HotScotch4321/2200/PCB_Projects/SensorBoard/EGB220_Ordering_MaximusVu.xlsx

TS EE&I Order Template v3
Name | Maximus Vu |  | Unit | EGB220 |  |  | Do not leave empty cells in the descriptions.
Email | n11494581@qut.edu.au |  | Group | B6 |  |  | Do not change formatting or file type.
Account | 323500-0161-01 ( EER UG Students ) |  |  |  |  |  | Complete this form and email to foe.eei@qut.edu.au
Supervisor | Matthew Dunbabin |  | Multiplier | 1 |  |  | Also cc your supervisor who will authorise the order
Item | Description | Quantity | Cost Each | Currency | Supplier | Order Code | Web Link
1 | CAP CER 0.1UF 100V X7R 1206 | 1 | $0.32 | AUD | digikey | 478-KGM31DR72A104KUCT-ND | https://www.digikey.com.au/en/products/detail/kyocera-avx/KGM31DR72A104KU/563639
2 | LED RED CLEAR 0603 SMD | 1 | $0.22 | AUD | digikey | 732-4978-1-ND | https://www.digikey.com.au/en/products/detail/w%C3%BCrth-elektronik/150060RS75000/4489901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
3 | RES 200 OHM 1% 1/2W 1206 | 14 | $0.03 | AUD | digikey | RNCP1206FTD200RCT-ND | https://www.digikey.com.au/en/products/detail/stackpole-electronics-inc/RNCP1206FTD200R/2240320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
4 | RES 10K OHM 5% 1/4W 1206 | 14 | $0.06 | AUD | digikey | A130183CT-ND | https://www.digikey.com.au/en/products/detail/te-connectivity-passive-product/CRGCQ1206J10K/8576785
5 | RES SMD 150 OHM 5% 1/10W 0603 | 1 | $0.15 | AUD | digikey | CR0603-JW-151ELFCT-ND | https://www.digikey.com.au/en/products/detail/bourns-inc/CR0603-JW-151ELF/3784293
6 | SENSOR OPTO TRANS REFL SMD PHOTO | 14 | $1.13 | AUD | digikey | QRE1113GRCT-ND | https://www.digikey.com.au/en/products/detail/onsemi/QRE1113GR/965451
7 | IC MUX 16:1 160OHM 24SOIC | 1 | $1.15 | AUD | digikey | 296-29408-1-ND | https://www.digikey.com.au/en/products/detail/texas-instruments/CD74HC4067M96/1507236
8
9
10
11
12
13
14
15
16
17
18
19
20
21
22
23
24
25
26
27
28
29
30
31
32
33
34
35
36
37
38
39
40
41
42
43
44
45
46
47
48
49
50
