HotScotch4321/2200/PCB_Projects/breakoutB/STEP_file/.step

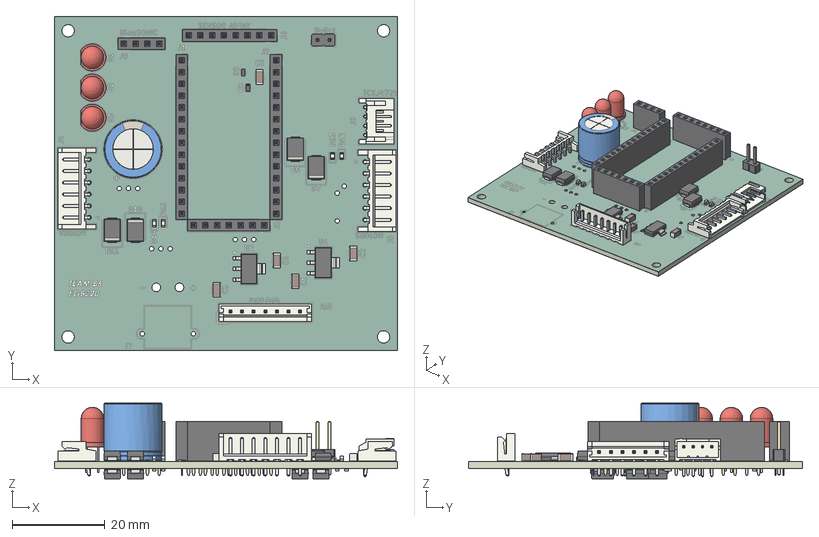
[picture p1: CAD file, 2026-05-04]
PCB_Projects/breakoutB/STEP_file/.step
74.0 x 72.0 x 16.3 mm
C_1206_3216Metric x 5
PinSocket_1x08_P2.54mm_Vertical
PinSocket_1x07_P2.54mm_Vertical
LED_0603_1608Metric x 4
CP_Radial_D12.5mm_P5.00mm
SOT-223 x 2
PinSocket_1x14_P2.54mm_Vertical x 2
R_0603_1608Metric x 9
JST_EH_S6B-EH_1x06_P2.50mm_Horizontal x 2
D_SMB x 8
LED_D5.0mm x 3
JST_PH_S4B-PH-K_1x04_P2.00mm_Horizontal
PinSocket_1x04_P2.54mm_Vertical
PinHeader_1x02_P2.54mm_Vertical
JST_EH_B7B-EH-A_1x07_P2.50mm_Vertical
breakoutB_silkscreen x 2
breakoutB_soldermask x 2
breakoutB_PCB
