HotScotch4321/2200/PCB_Projects/LDL1117S50R_/LDL1117S50R_.step

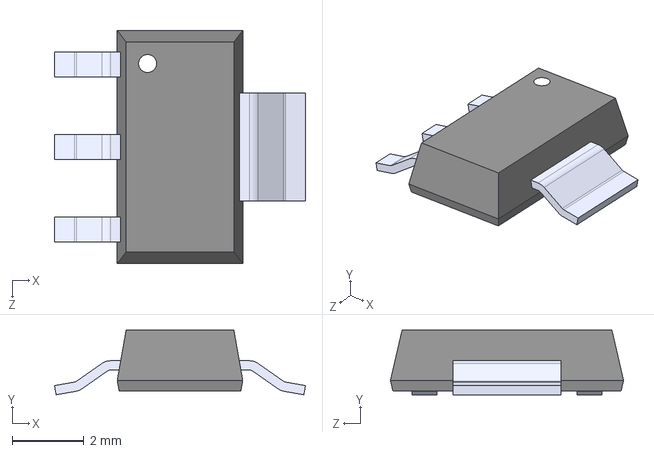
[picture p2: CAD file, 2026-05-04]
PCB_Projects/LDL1117S50R_/LDL1117S50R_.step
7.00 x 1.80 x 6.50 mm
