HotScotch4321/2200/PCB_Projects/SensorBoard/Fusion/Sensor_board.step

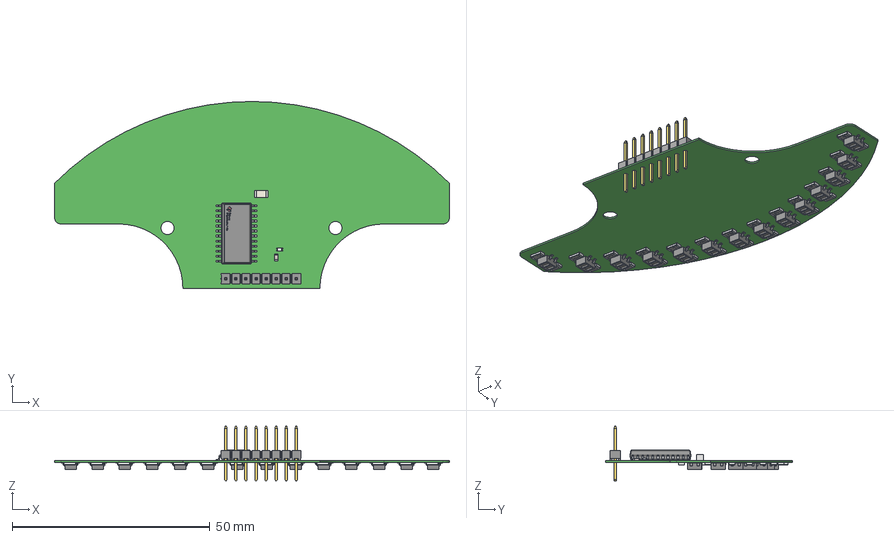
[picture p3: CAD file, 2026-03-11]
PCB_Projects/SensorBoard/Fusion/Sensor_board.step
99.8 x 47.3 x 13.8 mm
Extruded x 6
IC_ON_Semi_QRE1113GR_eec x 70
pins x 14
top x 14
part number x 14
Res_Stackpole_Electronics_RNCP1206FTD1K00_eec x 98
BODY-SO
LEAD-SO x 24
Texas Logo Yury
Texas Logo Yury - Copy
housing
cover
base x 2
Polarity Mark
TSW-108-08-G-S_body
T-1S6-08-TSW-1-08-8-S
