HotScotch4321/2200/(list of files, cad)

Other CAD files:
PCB_Projects/breakoutB/STEP_file/BreakoutBoard.step
