HotScotch4321/2200/firmware/SparkMOB/test/data_fig1_sensor.csv

line_offset_mm | computed_position_units_clean | computed_position_units_noisy
-45.00 | -272.23 | -311.56
-44.80 | -281.48 | -313.85
-44.60 | -290.65 | -264.17
-44.40 | -299.71 | -292.25
-44.20 | -308.65 | -281.66
-44.00 | -317.44 | -312.92
-43.80 | -326.09 | -327.80
-43.60 | -334.57 | -321.21
-43.40 | -342.88 | -342.26
-43.20 | -350.99 | -370.73
-43.00 | -358.91 | -358.05
-42.80 | -366.62 | -379.01
-42.60 | -374.12 | -401.15
-42.40 | -381.41 | -374.22
-42.20 | -388.47 | -382.03
-42.00 | -395.30 | -377.82
-41.80 | -401.90 | -440.82
-41.60 | -408.28 | -426.97
-41.40 | -414.42 | -447.84
-41.20 | -420.32 | -395.73
-41.00 | -426.00 | -416.15
-40.80 | -431.44 | -432.16
-40.60 | -436.65 | -423.63
-40.40 | -441.63 | -439.44
-40.20 | -446.39 | -440.49
-40.00 | -450.92 | -439.60
-39.80 | -455.23 | -457.62
-39.60 | -459.32 | -448.92
-39.40 | -463.20 | -464.16
-39.20 | -466.87 | -463.19
-39.00 | -470.32 | -467.26
-38.80 | -473.57 | -462.89
-38.60 | -476.62 | -473.37
-38.40 | -479.47 | -468.28
-38.20 | -482.13 | -493.09
-38.00 | -484.60 | -489.94
-37.80 | -486.88 | -478.71
-37.60 | -488.97 | -499.39
-37.40 | -490.89 | -516.47
-37.20 | -492.63 | -491.76
-37.00 | -494.19 | -498.83
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
