HotScotch4321/2200/firmware/SparkMOB/test/data_fig2_line_pd.csv

time_s | pos_Kp1.0_Kd0.0 | pos_Kp1.0_Kd0.1 | pos_Kp1.0_Kd0.5
0.000 | 63.72 | 63.72 | 63.72
0.010 | 62.55 | 62.05 | 62.05
0.020 | 60.21 | 58.86 | 60.09
0.030 | 56.77 | 55.16 | 58.83
0.040 | 52.26 | 51.12 | 57.65
0.050 | 46.76 | 46.86 | 56.49
0.060 | 40.36 | 42.51 | 55.36
0.070 | 33.17 | 38.15 | 54.25
0.080 | 25.31 | 33.89 | 53.16
0.090 | 16.92 | 29.77 | 52.09
0.100 | 8.17 | 25.85 | 51.05
0.110 | -0.75 | 22.18 | 50.03
0.120 | -9.65 | 18.78 | 49.02
0.130 | -18.35 | 15.66 | 48.04
0.140 | -26.66 | 12.83 | 47.08
0.150 | -34.42 | 10.30 | 46.13
0.160 | -41.49 | 8.05 | 45.21
0.170 | -47.75 | 6.08 | 44.30
0.180 | -53.08 | 4.37 | 43.41
0.190 | -57.42 | 2.90 | 42.54
0.200 | -60.68 | 1.66 | 41.69
0.210 | -62.82 | 0.62 | 40.86
0.220 | -63.80 | -0.23 | 40.04
0.230 | -63.60 | -0.91 | 39.23
0.240 | -62.24 | -1.44 | 38.45
0.250 | -59.71 | -1.84 | 37.68
0.260 | -56.09 | -2.13 | 36.92
0.270 | -51.41 | -2.33 | 36.18
0.280 | -45.75 | -2.44 | 35.46
0.290 | -39.21 | -2.48 | 34.75
0.300 | -31.90 | -2.47 | 34.05
0.310 | -23.94 | -2.41 | 33.37
0.320 | -15.48 | -2.32 | 32.70
0.330 | -6.69 | -2.20 | 32.04
0.340 | 2.24 | -2.06 | 31.40
0.350 | 11.13 | -1.91 | 30.77
0.360 | 19.77 | -1.75 | 30.16
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
