HotScotch4321/2200/firmware/SparkMOB/test/data_fig4_timeline.csv

time_s | left_wheel_ms | right_wheel_ms | state
0.000 | 0.0944 | 0.0944 | FOLLOW (straight)
0.010 | 0.1731 | 0.1731 | FOLLOW (straight)
0.020 | 0.2387 | 0.2387 | FOLLOW (straight)
0.030 | 0.2934 | 0.2934 | FOLLOW (straight)
0.040 | 0.3389 | 0.3389 | FOLLOW (straight)
0.050 | 0.3769 | 0.3769 | FOLLOW (straight)
0.060 | 0.4085 | 0.4085 | FOLLOW (straight)
0.070 | 0.4281 | 0.4309 | FOLLOW (straight)
0.080 | 0.4350 | 0.4400 | FOLLOW (straight)
0.090 | 0.4351 | 0.4417 | FOLLOW (straight)
0.100 | 0.4316 | 0.4396 | FOLLOW (straight)
0.110 | 0.4267 | 0.4358 | FOLLOW (straight)
0.120 | 0.4214 | 0.4316 | FOLLOW (straight)
0.130 | 0.4163 | 0.4275 | FOLLOW (straight)
0.140 | 0.4118 | 0.4238 | FOLLOW (straight)
0.150 | 0.4078 | 0.4207 | FOLLOW (straight)
0.160 | 0.4044 | 0.4181 | FOLLOW (straight)
0.170 | 0.4016 | 0.4161 | FOLLOW (straight)
0.180 | 0.3993 | 0.4145 | FOLLOW (straight)
0.190 | 0.3974 | 0.4133 | FOLLOW (straight)
0.200 | 0.3959 | 0.4124 | FOLLOW (straight)
0.210 | 0.3946 | 0.4118 | FOLLOW (straight)
0.220 | 0.3936 | 0.4113 | FOLLOW (straight)
0.230 | 0.3927 | 0.4110 | FOLLOW (straight)
0.240 | 0.3920 | 0.4109 | FOLLOW (straight)
0.250 | 0.3914 | 0.4108 | FOLLOW (straight)
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
