HotScotch4321/2200/firmware/SparkMOB/test/line_Kp0p3.csv

t_ms | position | error | pid_out
0 | 66 | -66 | 0
10 | 39 | -39 | 0
20 | 43 | -43 | 0
30 | 35 | -35 | 0
40 | 31 | -31 | 0
50 | 27 | -27 | 0
60 | 21 | -21 | 0
70 | 20 | -20 | 0
80 | 16 | -16 | 0
90 | 18 | -18 | 0
100 | 10 | -10 | 0
110 | 8 | -8 | 0
120 | 5 | -5 | 0
130 | 3 | -3 | 0
140 | 1 | -1 | 0
150 | 0 | 0 | 0
160 | -1 | 1 | 0
170 | -3 | 3 | 0
180 | -3 | 3 | 0
190 | -6 | 6 | 0
200 | -6 | 6 | 0
210 | -5 | 5 | 0
220 | -8 | 8 | 0
230 | -9 | 9 | 0
240 | -9 | 9 | 0
250 | -9 | 9 | 0
260 | -8 | 8 | 0
270 | -11 | 11 | 0
280 | -11 | 11 | 0
290 | -9 | 9 | 0
300 | -12 | 12 | 0
310 | -11 | 11 | 0
320 | -10 | 10 | 0
330 | -10 | 10 | 0
340 | -10 | 10 | 0
350 | -9 | 9 | 0
360 | -14 | 14 | 0
370 | -8 | 8 | 0
380 | -11 | 11 | 0
390 | -11 | 11 | 0
400 | -8 | 8 | 0
410 | -8 | 8 | 0
420 | -9 | 9 | 0
430 | -9 | 9 | 0
440 | -7 | 7 | 0
450 | -7 | 7 | 0
460 | -5 | 5 | 0
470 | -6 | 6 | 0
480 | -6 | 6 | 0
490 | -5 | 5 | 0
500 | -6 | 6 | 0
510 | -7 | 7 | 0
520 | -4 | 4 | 0
530 | -4 | 4 | 0
540 | -5 | 5 | 0
550 | -5 | 5 | 0
560 | -4 | 4 | 0
570 | -7 | 7 | 0
580 | -2 | 2 | 0
590 | -3 | 3 | 0
600 | -5 | 5 | 0
610 | -2 | 2 | 0
620 | -4 | 4 | 0
630 | -1 | 1 | 0
640 | -5 | 5 | 0
650 | -2 | 2 | 0
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
