HotScotch4321/2200/firmware/SparkMOB/test/line_Kp1p0.csv

t_ms | position | error | pid_out
0 | 62 | -62 | 0
10 | 30 | -30 | 0
20 | 25 | -25 | 0
30 | 13 | -13 | 0
40 | 5 | -5 | 0
50 | 4 | -4 | 0
60 | 0 | 0 | 0
70 | -1 | 1 | 0
80 | -5 | 5 | 0
90 | -2 | 2 | 0
100 | -4 | 4 | 0
110 | -3 | 3 | 0
120 | -6 | 6 | 0
130 | -5 | 5 | 0
140 | -7 | 7 | 0
150 | -1 | 1 | 0
160 | -9 | 9 | 0
170 | -2 | 2 | 0
180 | -6 | 6 | 0
190 | -5 | 5 | 0
200 | -4 | 4 | 0
210 | -4 | 4 | 0
220 | -3 | 3 | 0
230 | -4 | 4 | 0
240 | -1 | 1 | 0
250 | -6 | 6 | 0
260 | -2 | 2 | 0
270 | -4 | 4 | 0
280 | -1 | 1 | 0
290 | -5 | 5 | 0
300 | -1 | 1 | 0
310 | -2 | 2 | 0
320 | -4 | 4 | 0
330 | 0 | 0 | 0
340 | -2 | 2 | 0
350 | 0 | 0 | 0
360 | -1 | 1 | 0
370 | -3 | 3 | 0
380 | -2 | 2 | 0
390 | -1 | 1 | 0
400 | 0 | 0 | 0
410 | -1 | 1 | 0
420 | -3 | 3 | 0
430 | -2 | 2 | 0
440 | -2 | 2 | 0
450 | -1 | 1 | 0
460 | -1 | 1 | 0
470 | -1 | 1 | 0
480 | 2 | -2 | 0
490 | -3 | 3 | 0
500 | -1 | 1 | 0
510 | 0 | 0 | 0
520 | -2 | 2 | 0
530 | 0 | 0 | 0
540 | 0 | 0 | 0
550 | 0 | 0 | 0
560 | -3 | 3 | 0
570 | 2 | -2 | 0
580 | -2 | 2 | 0
590 | 0 | 0 | 0
600 | 0 | 0 | 0
610 | 0 | 0 | 0
620 | 0 | 0 | 0
630 | -1 | 1 | 0
640 | -1 | 1 | 0
650 | 0 | 0 | 0
660 | -2 | 2 | 0
670 | 2 | -2 | 0
680 | -2 | 2 | 0
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
