HotScotch4321/2200/firmware/SparkMOB/test/fig_test_slowzone.png

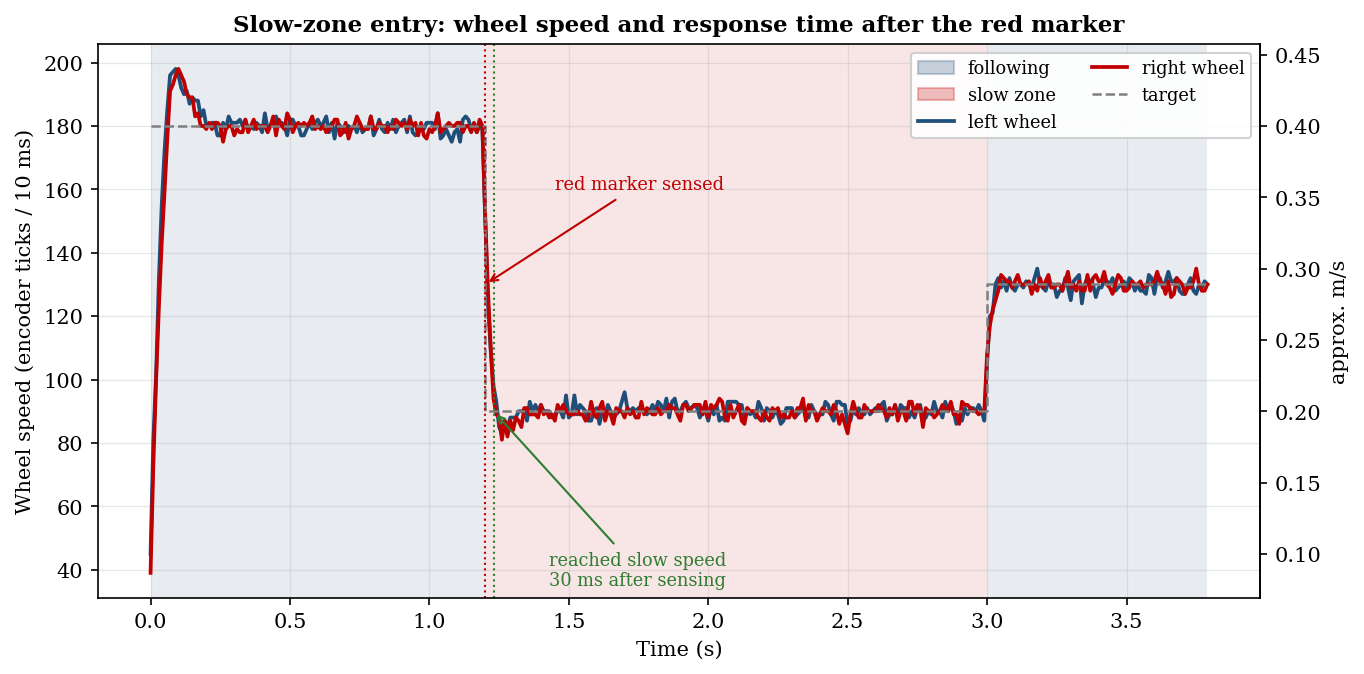
firmware/SparkMOB/test/fig_test_slowzone.png
