HotScotch4321/2200/firmware/SparkMOB/test/fig_test_speed.png

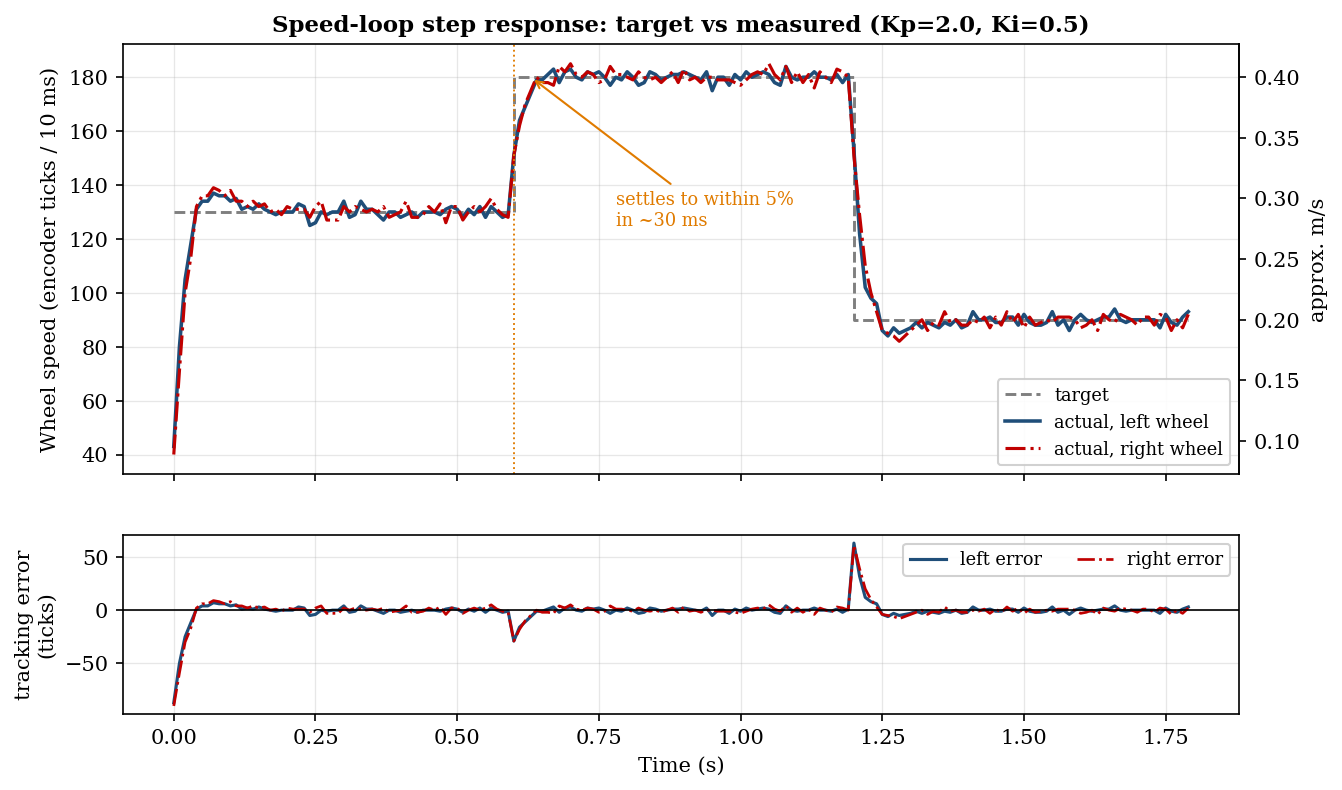
firmware/SparkMOB/test/fig_test_speed.png
