HotScotch4321/2200/(list of files, drawings)

Other design files:
PCB_Projects/breakoutSch/Breakout.SchDoc
PCB_Projects/MainBreakout.PrjPcb
PCB_Projects/Sensor_array.SchDoc
PCB_Projects/SensorBoard/board.SchDoc
PCB_Projects/SensorBoard/Copy of Sensor_board.PcbDoc
PCB_Projects/SensorBoard/sensor.SchDoc
PCB_Projects/SensorBoard/Sensor_board.PcbDoc
PCB_Projects/SensorBoard/SensorBoard.PrjPcb
