HotScotch4321/2200/PCB_Projects/breakoutB/breakoutB.kicad_pcb

## KiCad design PCB_Projects/breakoutB/breakoutB.kicad_pcb (2026-05-04)

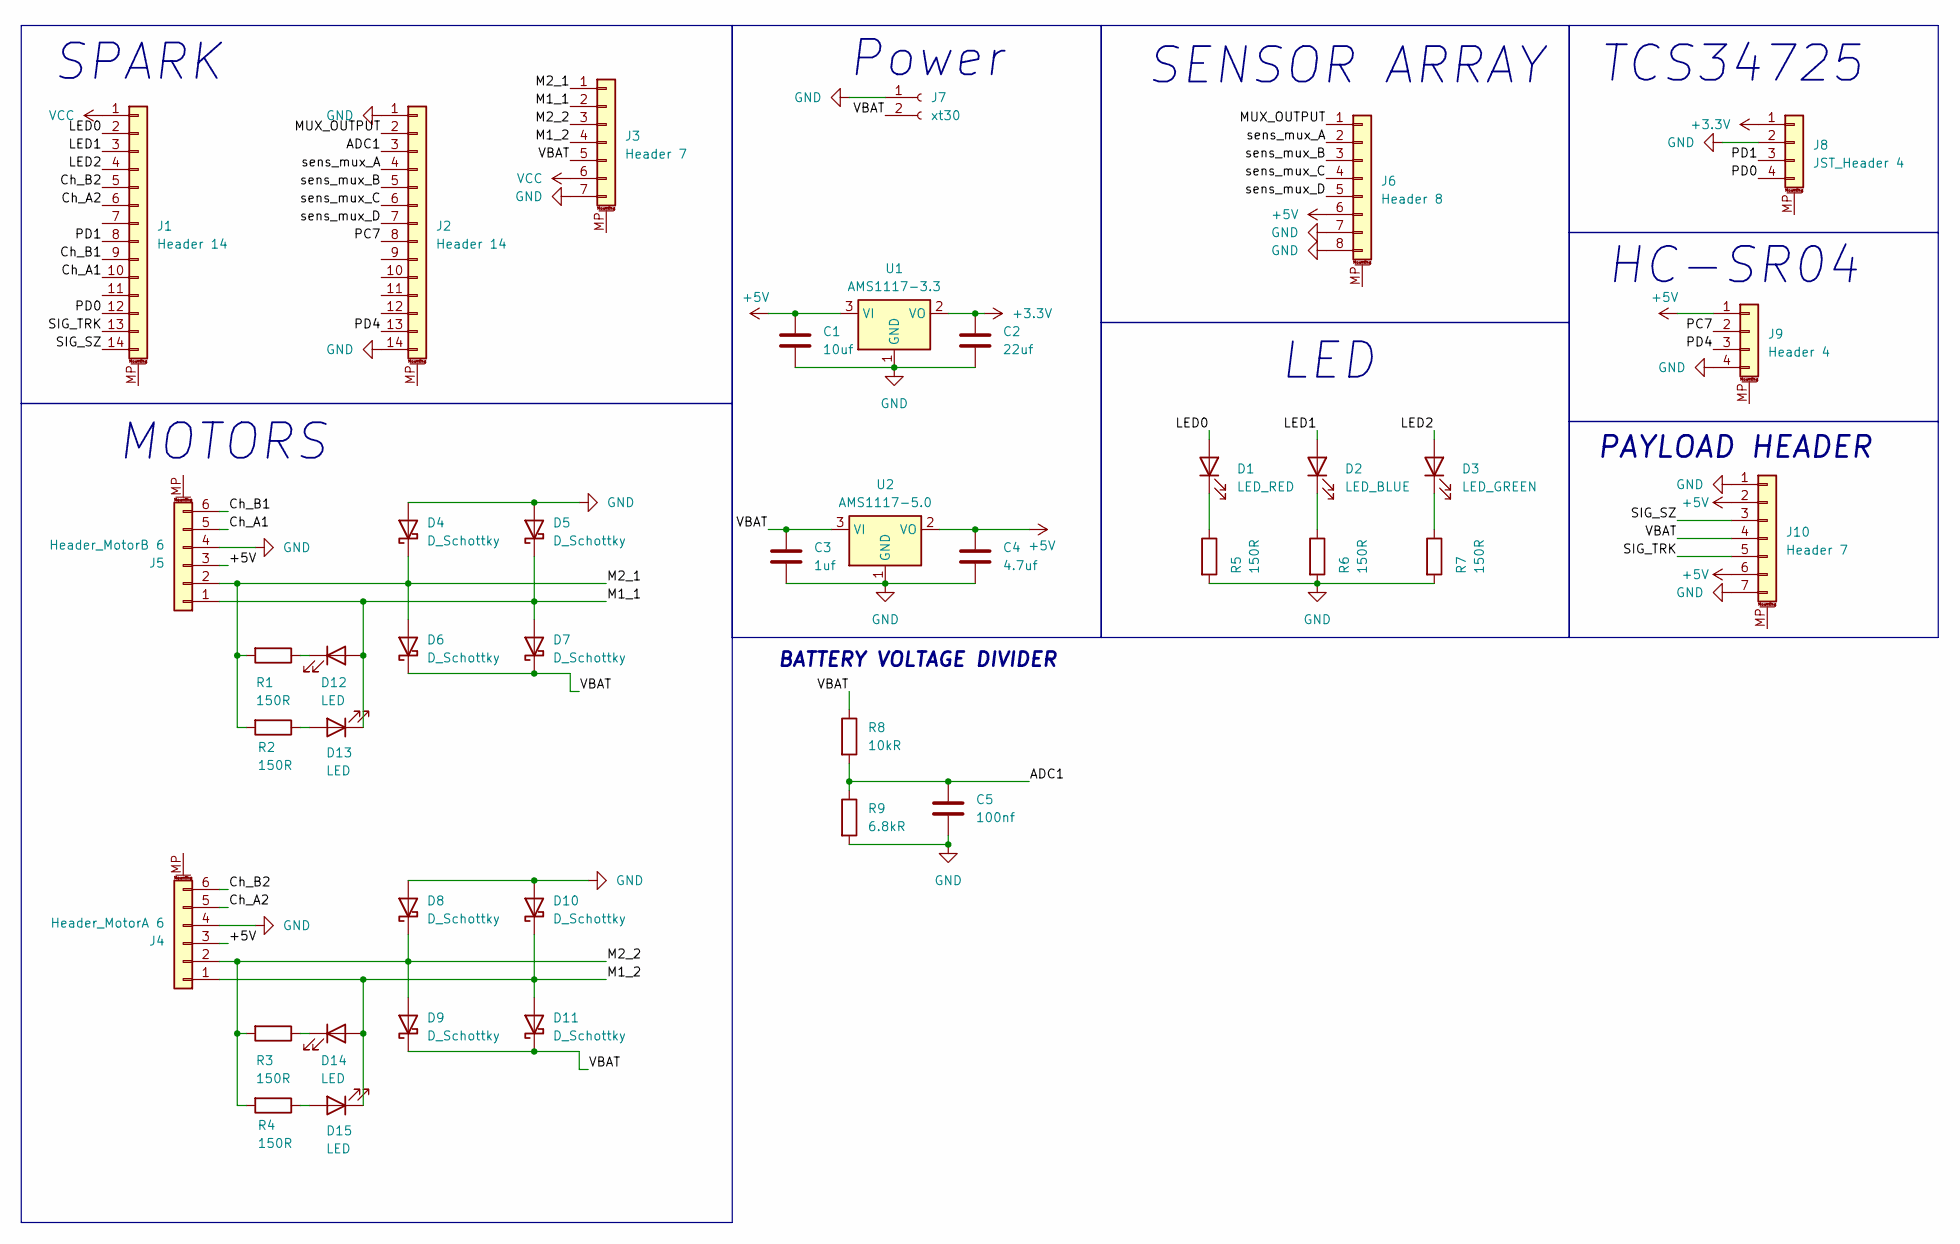
[picture p7: schematic breakoutB.kicad_sch]

Parts:
C1: 10uf; C_1206_3216Metric
C2: 22uf; C_1206_3216Metric
C3: 1uf; C_1206_3216Metric
C4: 4.7uf; C_1206_3216Metric
C5: 100nf; C_1206_3216Metric
D1: LED_RED; LED_D5.0mm
D2: LED_BLUE; LED_D5.0mm
D3: LED_GREEN; LED_D5.0mm
D4, D5, D6, D7, D8, D9, D10, D11: D_Schottky; D_SMB
D12, D13, D14, D15: LED; LED_0603_1608Metric
J1, J2: Header 14; PinSocket_1x14_P2.54mm_Vertical
J3: Header 7; PinSocket_1x07_P2.54mm_Vertical
J4: Header_MotorA 6; JST_EH_S6B-EH_1x06_P2.50mm_Horizontal
J5: Header_MotorB 6; JST_EH_S6B-EH_1x06_P2.50mm_Horizontal
J6: Header 8; PinSocket_1x08_P2.54mm_Vertical
J7: xt30; AMASS_XT30PW-M_1x02_P2.50mm_Horizontal
J8: JST_Header 4; JST_PH_S4B-PH-K_1x04_P2.00mm_Horizontal
J9: Header 4; PinSocket_1x04_P2.54mm_Vertical
J10: Header 7; JST_EH_B7B-EH-A_1x07_P2.50mm_Vertical
R1, R2, R3, R4, R5, R6, R7: 150R; R_0603_1608Metric
R8: 10kR; R_0603_1608Metric
R9: 6.8kR; R_0603_1608Metric
U1: AMS1117-3.3; SOT-223-3_TabPin2
U2: AMS1117-5.0; SOT-223-3_TabPin2

Connections:
+3.3V: C2.1, J8.1, U1.2 (VO)
+5V: C1.1, C4.1, J4.3, J5.3, J6.6, J9.1, J10.2, J10.6, U1.3 (VI), U2.2 (VO)
/ADC1: C5.1, J2.3, R8.2, R9.1
/Ch_A1: J1.10, J5.5
/Ch_A2: J1.6, J4.5
/Ch_B1: J1.9, J5.6
/Ch_B2: J1.5, J4.6
/LED0: D1.2 (A), J1.2
/LED1: D2.2 (A), J1.3
/LED2: D3.2 (A), J1.4
/M1_1: D5.1 (K), D7.2 (A), D12.2 (A), D13.1 (K), J3.2, J5.1
/M1_2: D10.1 (K), D11.2 (A), D14.2 (A), D15.1 (K), J3.4, J4.1
/M2_1: D4.1 (K), D6.2 (A), J3.1, J5.2, R1.2, R2.2
/M2_2: D8.1 (K), D9.2 (A), J3.3, J4.2, R3.2, R4.2
/MUX_OUTPUT: J2.2, J6.1
/PC7: J2.8, J9.2
/PD0: J1.12, J8.4
/PD1: J1.8, J8.3
/PD4: J2.13, J9.3
/SIG_SZ: J1.14, J10.3
/SIG_TRK: J1.13, J10.5
/VBAT: C3.1, D6.1 (K), D7.1 (K), D9.1 (K), D11.1 (K), J3.5, J7.2, J10.4, R8.1, U2.3 (VI)
/sens_mux_A: J2.4, J6.2
/sens_mux_B: J2.5, J6.3
/sens_mux_C: J2.6, J6.4
/sens_mux_D: J2.7, J6.5
GND: C1.2, C2.2, C3.2, C4.2, C5.2, D4.2 (A), D5.2 (A), D8.2 (A), D10.2 (A), J2.1, J2.14, J3.7, J4.4, J5.4, J6.7, J6.8, J7.1, J8.2, J9.4, J10.1, J10.7, R5.2, R6.2, R7.2, R9.2, U1.1 (GND), U2.1 (GND)
unnamed: D1.1 (K), R5.1
unnamed: D2.1 (K), R6.1
unnamed: D3.1 (K), R7.1
unnamed: D12.1 (K), R1.1
unnamed: D13.2 (A), R2.1
unnamed: D14.1 (K), R3.1
unnamed: D15.2 (A), R4.1
PB7: J1.11
VCC: J1.1, J3.6
adc11: J2.10

Notes on the sheet:
PAYLOAD HEADER
MOTORS
HC-SR04
SENSOR ARRAY
Power
BATTERY VOLTAGE DIVIDER
TCS34725
LED
SPARK

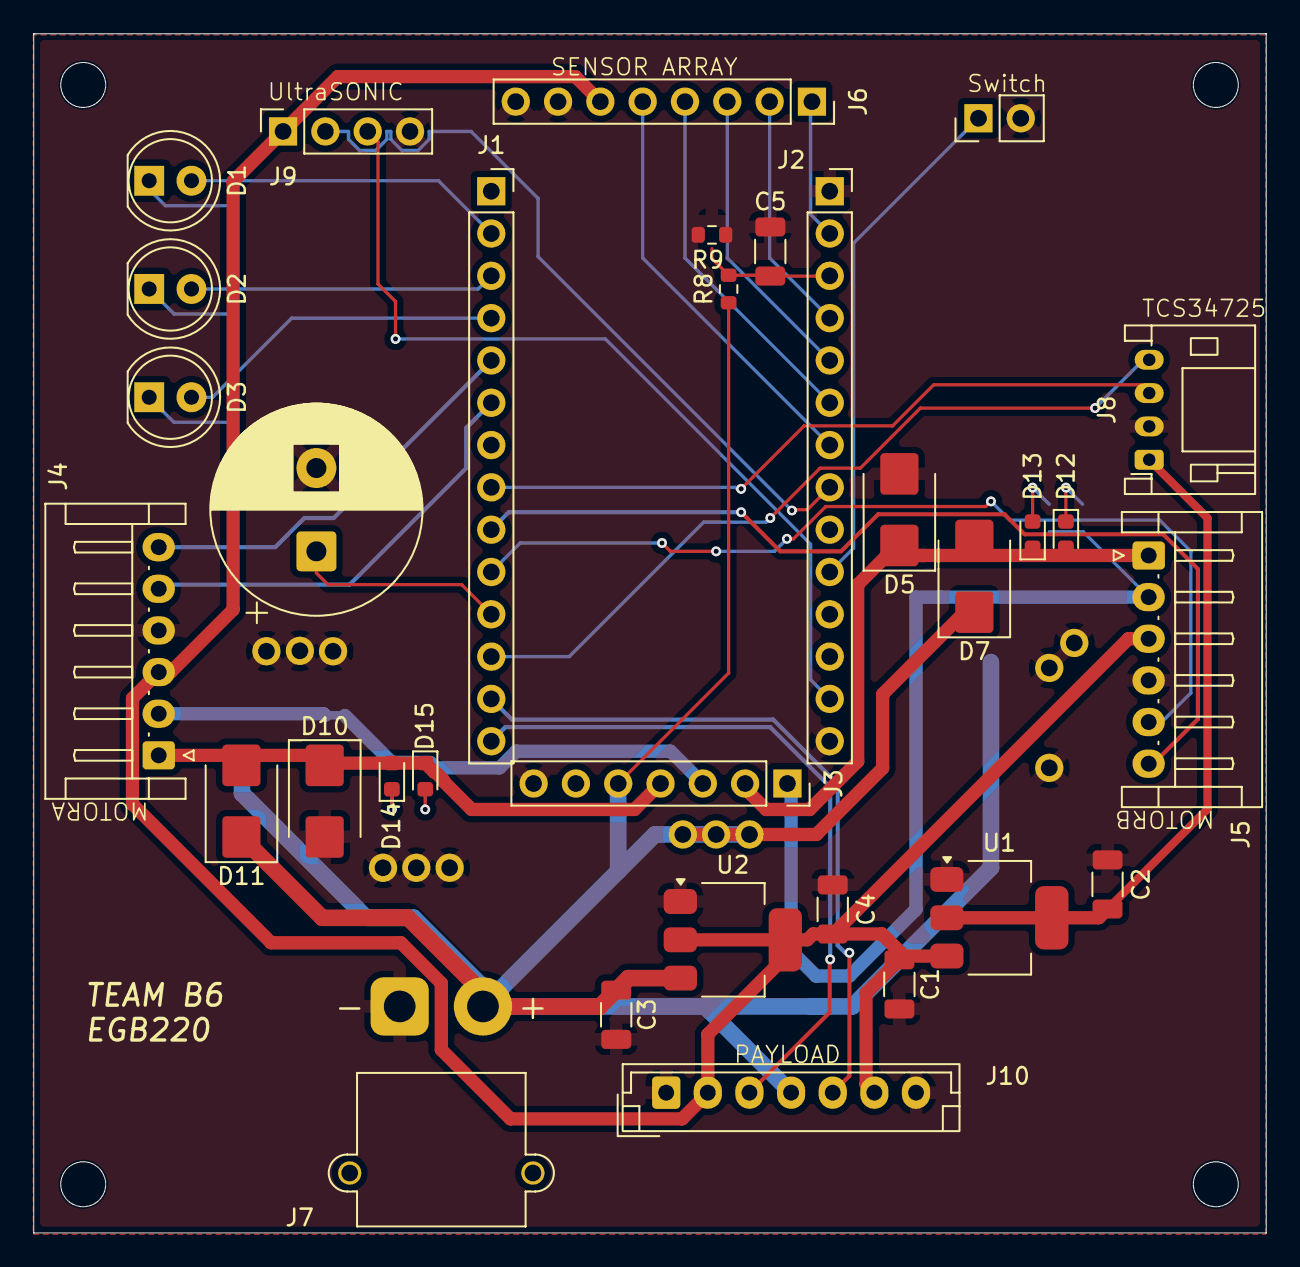
[picture p8: board breakoutB.kicad_pcb from above]

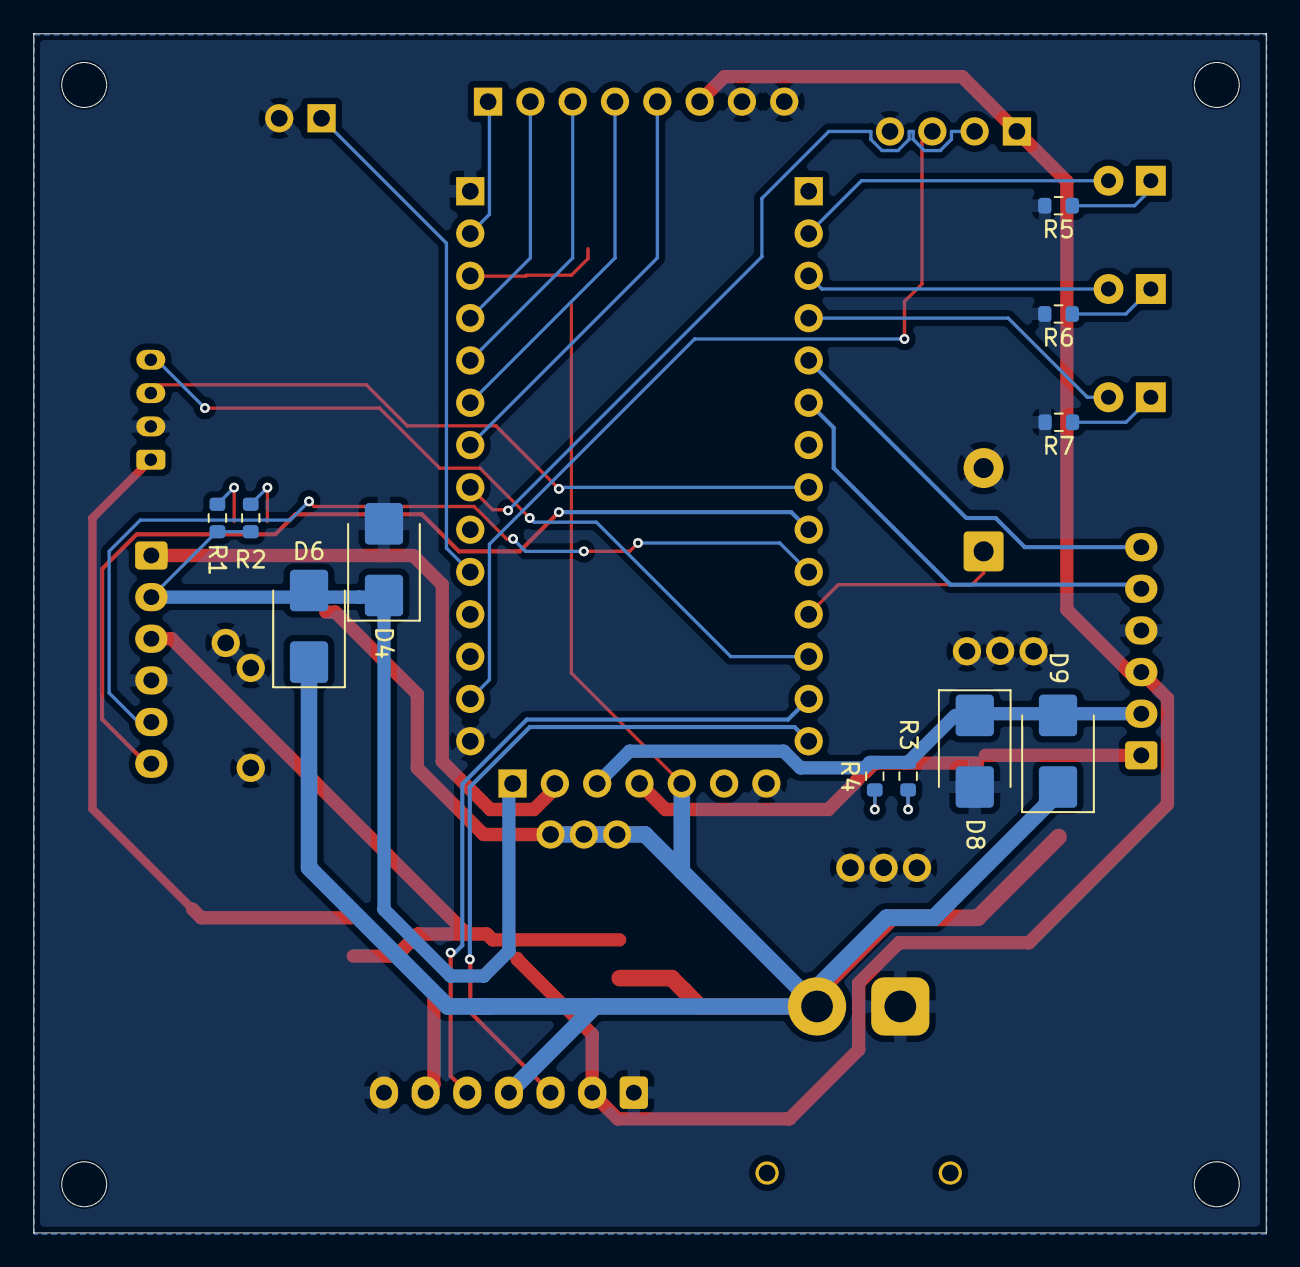
[picture p9: board breakoutB.kicad_pcb from below]

Board: 2 copper layers, 74.0 x 72.0 mm, 41 parts (11 on the bottom side), 35 nets.
