HotScotch4321/2200/PCB_Projects/SensorBoardKICAD/converted/SensorBoard/SensorBoard.kicad_pcb

## KiCad design PCB_Projects/SensorBoardKICAD/converted/SensorBoard/SensorBoard.kicad_pcb (2026-05-04)

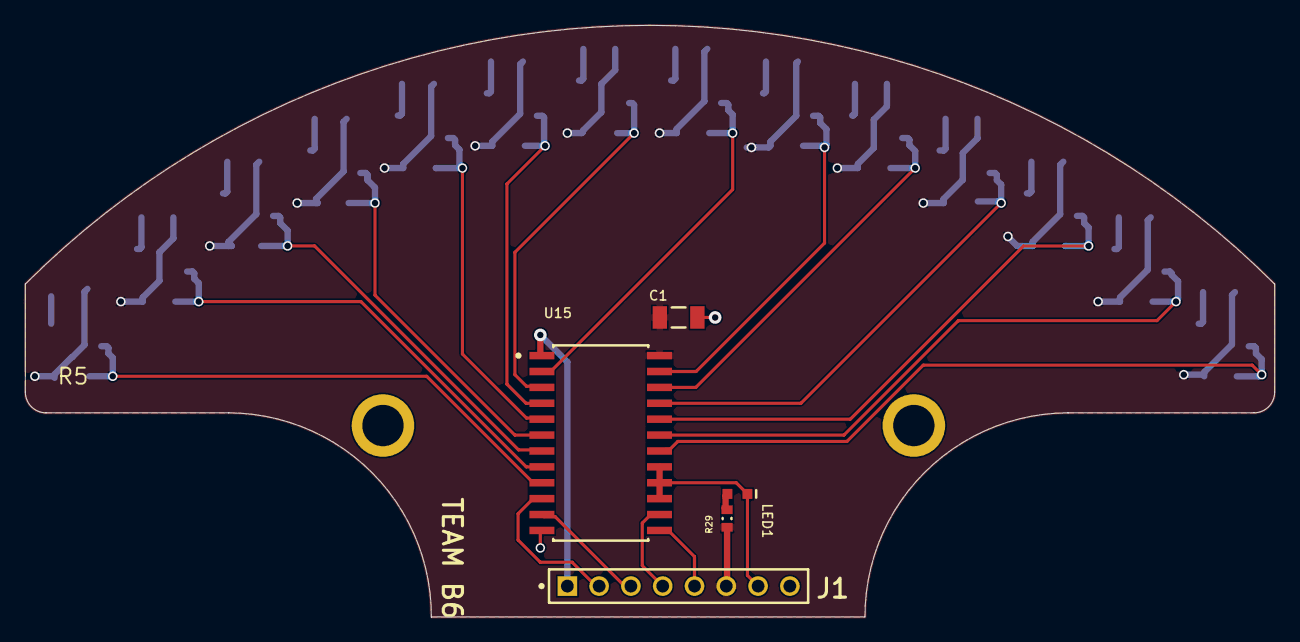
[picture p10: board SensorBoard.kicad_pcb from above]

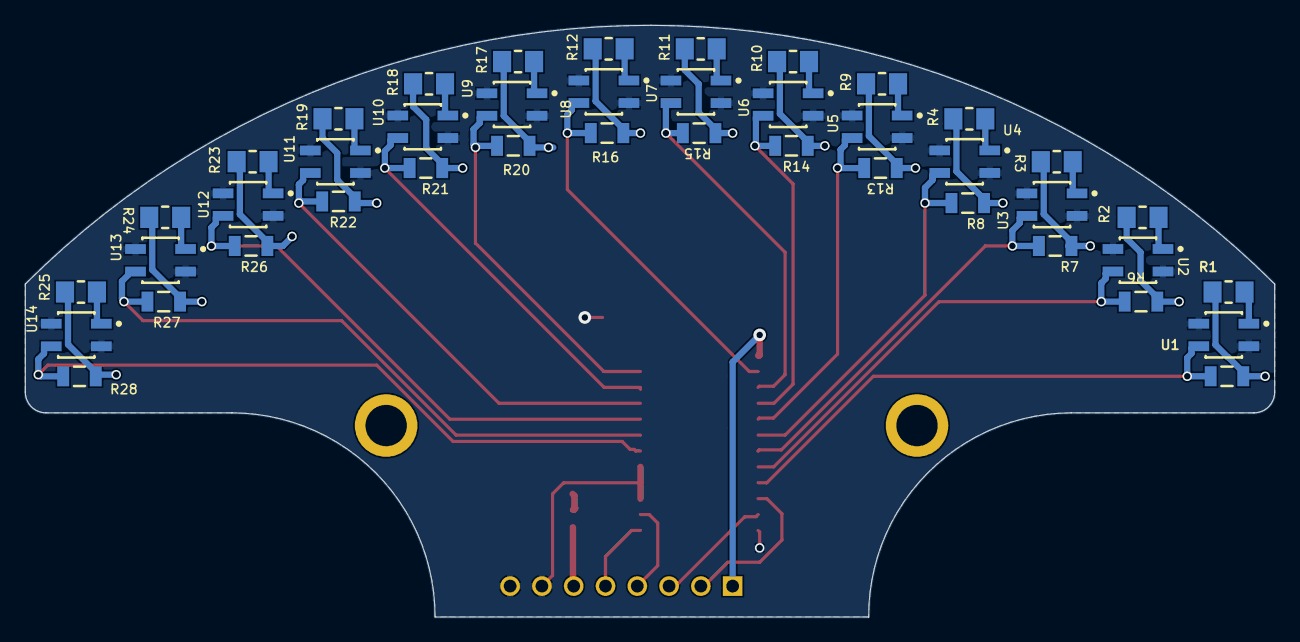
[picture p11: board SensorBoard.kicad_pcb from below]

Board: 2 copper layers, 99.8 x 47.3 mm, 47 parts (42 on the bottom side), 36 nets.

Parts:
C1: CAP 100nF 100V 1206(3216); CAPC1206(3216)150_N
J1: TSW-108-08-G-S; FP-TSW-108-08-G-S-MFG
LED1: 2V 20mA 0603 Red; 0603_A
R1, R2, R3, R4, R9, R10, R11, R12, R17, R18, R19, R23, R24, R25: RNCP1206FTD200R; FP-RNCP1206-IPC_B
R5, R6, R7, R8, R13, R14, R15, R16, R20, R21, R22, R26, R27, R28: CRGCQ1206J10K; FP-CRGCQ1206-IPC_C
R29: 150R 5% 0603(1608); RESC0603(1608)_L
U1, U2, U3, U4, U5, U6, U7, U8, U9, U10, U11, U12, U13, U14: QRE1113GR; FP-100CY-MFG
U15: CD74HC4067M96; FP-DW0024A-MFG

Connections:
+5: C1.1, J1.6, R1.2, R2.2, R3.2, R4.2, R5.1, R6.1, R7.1, R8.1, R9.2, R10.2, R11.2, R12.2, R13.1, R14.1, R15.1, R16.1, R17.2, R18.2, R19.2, R20.1, R21.1, R22.1, R23.2, R24.2, R25.2, R26.1, R27.1, R28.1, R29.2, U15.24
GND: C1.2, J1.7, J1.8, LED1.1, U1.2, U1.4, U2.2, U2.4, U3.2, U3.4, U4.2, U4.4, U5.2, U5.4, U6.2, U6.4, U7.2, U7.4, U8.2, U8.4, U9.2, U9.4, U10.2, U10.4, U11.2, U11.4, U12.2, U12.4, U13.2, U13.4, U14.2, U14.4, U15.12, U15.15, U15.16, U15.17
MUX_OUTPUT: J1.1, U15.1
NetLED1_2: LED1.2, R29.1
NetR1_1: R1.1, U1.1
NetR2_1: R2.1, U2.1
NetR3_1: R3.1, U3.1
NetR4_1: R4.1, U4.1
NetR9_1: R9.1, U5.1
NetR10_1: R10.1, U6.1
NetR11_1: R11.1, U7.1
NetR12_1: R12.1, U8.1
NetR17_1: R17.1, U9.1
NetR18_1: R18.1, U10.1
NetR19_1: R19.1, U11.1
NetR23_1: R23.1, U12.1
NetR24_1: R24.1, U13.1
NetR25_1: R25.1, U14.1
SENS_MUX_A: J1.2, U15.10
SENS_MUX_B: J1.3, U15.11
SENS_MUX_C: J1.4, U15.14
SENS_MUX_D: J1.5, U15.13
sense_1: R5.2, U1.3, U15.9
sense_2: R6.2, U2.3, U15.8
sense_3: R7.2, U3.3, U15.7
sense_4: R8.2, U4.3, U15.6
sense_5: R13.2, U5.3, U15.5
sense_6: R14.2, U6.3, U15.4
sense_7: R15.2, U7.3, U15.3
sense_8: R16.2, U8.3, U15.2
sense_9: R20.2, U9.3, U15.23
sense_10: R21.2, U10.3, U15.22
sense_11: R22.2, U11.3, U15.21
sense_12: R26.2, U12.3, U15.20
sense_13: R27.2, U13.3, U15.19
sense_14: R28.2, U14.3, U15.18
