HotScotch4321/2200/firmware/SparkBOB/include/sensor.h

#pragma once

#include <avr/io.h>
#include <stdint.h>
#include <stdbool.h>

#define SENSOR_THRESHOLD 512

void init_ADC();
uint16_t read_ADC(uint8_t channel);
bool read_sensor_binary(uint8_t sensor_num);
uint16_t read_sensor(uint8_t sensor_num);
