HotScotch4321/2200/firmware/SparkMOB/src/timer.c

#include <avr/io.h>
#include <avr/interrupt.h>
#include "timer.h"

// Define the volatile flag that tells main() when to run the PID loop
volatile uint8_t pid_run_flag = 0;

// Setup timer 1 for 100Hz interrupt (10ms)
void init_timer() 
{
    // Disable global interrupts during setup
    cli();
    
    // Clear Timer/Counter Control Registers
    TCCR1A = 0;
    TCCR1B = 0;
    TCNT1  = 0;

    OCR1A = 19999; 
    TCCR1B |= (1 << WGM12);
    TCCR1B |= (1 << CS11);
    TIMSK1 |= (1 << OCIE1A);
    sei();
}

static volatile uint16_t timer_ticks = 0;

// Interrupt Service Routine that fires at 100Hz
ISR(TIMER1_COMPA_vect)
{
    //timer_ticks++;
    pid_run_flag = 1; 
}
