HotScotch4321/2200/(commit log)

2026-03-09 Add initial firmware structure with LED, sensor, and timer functionalities
2026-03-09 Refactor LED and sensor functionalities: update LED_on function signature, implement LED_off function, and enhance sensor reading logic
2026-03-11 Add PCB project assets and update firmware main.c
    Import a large set of PCB project files (BOM, schematics, PCB docs, previews, STEP export, DRC/outputs, project structure) and numerous history/backup ZIPs under PCB_Projects. Also modify firmware/SparkBOB/src/main.c. This commit adds the Altium project assets to the repository and includes a small firmware change to keep the code in sync with the hardware updates.
    [Breakout.SchDoc, Copy of Sensor_board.PcbDoc, MainBreakout.PrjPcb, SensorBoard.PrjPcb, Sensor_array.SchDoc, Sensor_board.PcbDoc, Sensor_board.step, board.SchDoc]
2026-03-15 feat: Implement motor and LED control firmware and establish initial PCB project files.
    [SensorBoard.PrjPcb]
2026-04-05 feat: update firmware source files and finalize PCB design project outputs
    [EGB220_Ordering_MaximusVu.xlsx, SensorBoard.PrjPcb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]
2026-04-05 feat: implement PID control logic and initialize KiCad project version history
2026-05-04 feat: PCB & tweak code
    [.kicad_sch.kicad_sch, .step, BreakoutBoard.step, LDL1117S50R_.step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]
2026-05-27 Add initial firmware structure and implement core functionalities
    - Created header files for battery, encoder, LED, multiplexer, PID controller, TCS34725 color sensor, TWI communication, and ultrasonic sensor.
    - Implemented source files for battery management, encoder reading, LED control, multiplexer handling, PID control logic, TCS34725 sensor interaction, TWI communication, and ultrasonic distance measurement.
    - Established a PlatformIO project configuration with a README for library management.
    - Developed a main application loop for robot control, including state management for line following and obstacle detection.
    - Added test files for unit testing and sensor verification.
2026-05-27 refactor: clean up comments and improve ADC warm-up logic in mux and tcs34725 modules
2026-05-27 switch code
2026-05-28 added motors
2026-05-28 refactor: update finish marker detection logic and clean up sensor handling
2026-05-29 refactor: update LED handling and bump switch initialization
2026-05-29 feat: add motor PWM pause and resume functions
